30Sativa/fleet-management-system/robot/ros2_ws/src/robot_control/README.md

# robot_control

Mode manager, launch files, and a small frontier explorer for the AMR real
robot flow.

## Command Architecture

```text
Manual:
teleop/joystick -> /cmd_vel_manual -> mode_manager -> /cmd_vel -> stm32_bridge

Auto explore:
simple_frontier_explorer -> Nav2 -> /cmd_vel_nav -> mode_manager -> /cmd_vel
  -> stm32_bridge
```

Only `mode_manager_node` should publish the final `/cmd_vel`. The STM32 bridge
subscribes only to `/cmd_vel`.

## Main Topics

| Topic | Type | Role |
|---|---|---|
| `/cmd_vel_manual` | `geometry_msgs/msg/Twist` | Manual keyboard/joystick input |
| `/cmd_vel_nav` | `geometry_msgs/msg/Twist` | Nav2 velocity output |
| `/cmd_vel` | `geometry_msgs/msg/Twist` | Final selected velocity for STM32 |
| `/robot_mode` | `std_msgs/msg/String` | Command mode: `manual` or `explore` |
| `/robot_mode_state` | `std_msgs/msg/String` | Current mode state |
| `/emergency_stop` | `std_srvs/srv/SetBool` | `true` engages, `false` releases |
| `/emergency_stop_state` | `std_msgs/msg/Bool` | Emergency stop state |
| `/scan` | `sensor_msgs/msg/LaserScan` | RPLiDAR scan |
| `/odom` | `nav_msgs/msg/Odometry` | STM32 step-count odometry |
| `/ultrasonic/sonar1/range` | `sensor_msgs/msg/Range` | SR04T SONAR1 |
| `/ultrasonic/sonar2/range` | `sensor_msgs/msg/Range` | SR04T SONAR2 |
| `/ultrasonic/sonar3/range` | `sensor_msgs/msg/Range` | SR04T SONAR3 |
| `/ultrasonic/sonar4/range` | `sensor_msgs/msg/Range` | SR04T SONAR4 |
| `/map` | `nav_msgs/msg/OccupancyGrid` | SLAM map |

## TF Frames

Expected real-robot tree:

```text
map -> odom -> base_footprint -> base_link -> lidar_link
```

The launch files run `robot_state_publisher` from `robot_description`. They pass
`base_frame:=base_footprint` into `stm32_bridge` so the bridge publishes
`odom -> base_footprint` and the URDF publishes fixed robot frames below it.

The RPLiDAR launch default uses `frame_id=lidar_link` to match the current URDF.
If your hardware driver is already publishing `laser`, either set
`lidar_frame:=laser` or update the URDF/static transform consistently.

## Build

```bash
cd ~/ros2_ws
rosdep install --from-paths src --ignore-src -r -y
colcon build --packages-select robot_control stm32_bridge robot_description
source install/setup.bash
```

## Manual Mode

```bash
ros2 launch robot_control manual_mode.launch.py \
  port:=/dev/ttyACM0 \
  baudrate:=115200
```

The launch leaves keyboard teleop out so it does not share or take over the
launch terminal. In a second terminal, run:

```bash
ros2 run teleop_twist_keyboard teleop_twist_keyboard --ros-args \
  -r cmd_vel:=/cmd_vel_manual
```

For joystick control, launch your joystick stack separately and remap its output
to `/cmd_vel_manual`.
The installed drivetrain uses `invert_left:=true invert_right:=true` by default
so the `i` key (positive ROS `linear.x`) moves the robot forward. Pass both as
`false` together only if a bench test confirms the motor wiring is already
forward-oriented.

## Manual Mapping

Use this first to build a map by driving manually.

```bash
ros2 launch robot_control manual_mapping.launch.py \
  port:=/dev/ttyACM0 \
  lidar_serial_port:=/dev/ttyUSB0
```

This launches:

- `stm32_bridge`
- `mode_manager_node`
- `rplidar_ros`
- `slam_toolbox` online async
- `robot_state_publisher`

In a second terminal, run `teleop_twist_keyboard` with the `/cmd_vel_manual`
remap shown above.

Save the map after a good mapping run:

```bash
ros2 run nav2_map_server map_saver_cli -f ~/maps/amr_map
```

### Manual Mapping With Gamepad + Astra Pro

For the current laptop/VMware hardware test, use the dedicated launch below.
It starts manual STM32 control, RPLiDAR, `slam_toolbox`, a Linux gamepad, and
the Astra Pro camera. Nav2 and frontier exploration are deliberately absent.

Install the gamepad packages once on the Ubuntu VM:

```bash
sudo apt install ros-humble-joy-linux ros-humble-teleop-twist-joy
```

```bash
ros2 launch robot_control manual_mapping_gamepad_camera.launch.py \
  port:=/dev/ttyACM0 \
  lidar_serial_port:=/dev/ttyUSB0 \
  joy_dev:=/dev/input/js0 \
  camera_x:=0.25 camera_y:=0.0 camera_z:=0.35 camera_pitch:=0.17
```

Before launching, verify the Linux device names:

```bash
ls -l /dev/ttyACM* /dev/ttyUSB* /dev/input/js*
```

During mapping, verify the data path in a second terminal:

```bash
ros2 topic echo /scan --once
ros2 topic echo /odom --once
ros2 topic echo /map --once
ros2 topic echo /joy --once
ros2 topic hz /camera/depth/image_raw
ros2 topic hz /camera/depth/points
```

Save the map after driving all required areas:

```bash
mkdir -p ~/maps
ros2 run nav2_map_server map_saver_cli -f ~/maps/amr_map
```

The gamepad mapping uses button `0` as a dead-man enable button, left stick
vertical for forward/backward, and left stick horizontal for rotation. Verify
the actual device first with `ls -l /dev/input/js*` and `ros2 topic echo
/joy --once`; VMware must pass the controller through to the Ubuntu guest.

The four SR04T sensors are carried in the STM32 feedback and exposed by the
bridge as `/ultrasonic/sonar1/range` through `/ultrasonic/sonar4/range`
(`sensor_msgs/msg/Range`). Check them while mapping:

```bash
ros2 topic echo /ultrasonic/sonar1/range
ros2 topic echo /ultrasonic/sonar2/range
ros2 topic echo /ultrasonic/sonar3/range
ros2 topic echo /ultrasonic/sonar4/range
```

The schematic mapping is `SONAR1: PB0=TRIG, PB1=ECHO`,
`SONAR2: PB11=TRIG, PB12=ECHO`, `SONAR3: PB13=TRIG, PB14=ECHO`, and
`SONAR4: PB15=TRIG, PA6=ECHO` (SONAR4's ECHO is the only one on GPIOA);
connector pin 2 is TRIG and pin 3 is ECHO (SONAR4's TRIG is on connector
pin 1). The temporary URDF places all four sensors at the four corners of
the chassis (SONAR1 front-left, SONAR2 front-right, SONAR3 rear-left,
SONAR4 rear-right), each facing diagonally outward. LiDAR is at the centre
of the roof, matching the current physical mount.
Confirm the SR04T Echo electrical level before powering it: the schematic
shows a direct connection to PB1/PB12/PB14/PA6, while some SR04T modules
output 5 V. Use a divider or level shifter if the installed module does not
guarantee a 3.3 V Echo signal. These ranges are for hardware testing only
and are not fed into `slam_toolbox` yet.

## Auto Explore

```bash
ros2 launch robot_control auto_explore.launch.py \
  port:=/dev/ttyACM0 \
  lidar_serial_port:=/dev/ttyUSB0
```

This launches SLAM, Nav2 navigation-while-mapping, and
`simple_frontier_explorer`. Nav2 is remapped so its velocity output goes to
`/cmd_vel_nav`; only `mode_manager_node` publishes final `/cmd_vel`.

Optional manual override inside auto explore:

```bash
ros2 launch robot_control auto_explore.launch.py enable_teleop:=true
```

Manual input has priority over Nav2 while it is fresh. When manual input times
out, explore mode returns control to Nav2.

## Change Mode

Switch to manual:

```bash
ros2 topic pub --once /robot_mode std_msgs/msg/String "{data: manual}"
```

Switch to explore:

```bash
ros2 topic pub --once /robot_mode std_msgs/msg/String "{data: explore}"
```

When switching from explore to manual, `mode_manager_node` publishes zero
velocity and requests cancellation of the active Nav2 `NavigateToPose` goal.

## Emergency Stop

Engage:

```bash
ros2 service call /emergency_stop std_srvs/srv/SetBool "{data: true}"
```

Release:

```bash
ros2 service call /emergency_stop std_srvs/srv/SetBool "{data: false}"
```

While emergency stop is engaged, `mode_manager_node` forces `/cmd_vel` to zero
and blocks manual/Nav2 commands. The STM32 bridge converts zero Twist to the
firmware `STOP,<seq>` command.

## Test Order

1. Manual motor test:
   `ros2 launch robot_control manual_mode.launch.py`
2. Confirm LiDAR:
   `ros2 topic echo /scan --once`
3. Manual mapping:
   `ros2 launch robot_control manual_mapping.launch.py`
4. Nav2 click-goal in RViz:
   run auto launch with `enable_explorer:=false`, then send a Nav2 goal.
5. Auto explore:
   `ros2 launch robot_control auto_explore.launch.py`

## Important Tuning TODOs

- `config/nav2_params.yaml`: `robot_radius=0.47` and `inflation_radius=0.60` are
  set from the real footprint (74x55 cm -> half-diagonal ~0.461 m). `max_vel_x`
  and `max_vel_theta` are still conservative bench defaults; tune on the robot.
- `wheel_base=0.4325` m (center-to-center, matched to robot_description).
  Re-measure if the axle spacing changes; it directly affects turn rate and
  odometry heading.
- `stm32_bridge` real wheel odometry uses `wheel_radius=0.09725`, matched to the
  URDF/controller geometry.
- STM32 feedback counts are generated STEP pulses, not physical encoder ticks.
  Odometry will drift if wheels slip or motors stall.

## Troubleshooting

Robot does not move:

- Check `/emergency_stop_state` is `false`.
- Check exactly one final publisher on `/cmd_vel`: `mode_manager_node`.
- Check `stm32_bridge` opened the serial port and is receiving `/cmd_vel`.
- Check firmware receives `CMD` or `STOP` with `tools/motor_serial_debug.ps1`.

Map is distorted:

- Verify `/odom` changes in the correct direction.
- Tune `wheel_radius`, `wheel_base`, `odom_invert_left`, and
  `odom_invert_right`.
- Confirm `/scan` frame matches a valid TF under `base_footprint`.

Nav2 does not accept goals:

- Confirm TF exists: `map -> odom -> base_footprint -> base_link -> lidar_link`.
- Confirm `/map`, `/odom`, and `/scan` are publishing.
- Run with `enable_explorer:=false` and test an RViz click goal first.

TF missing:

- Check `robot_state_publisher` is running.
- Check `stm32_bridge` was launched with `base_frame:=base_footprint`.
- Check RPLiDAR `frame_id` matches `lidar_link` or your chosen frame.

Multiple `/cmd_vel` publishers:

- Teleop must publish `/cmd_vel_manual`.
- Nav2 must publish `/cmd_vel_nav`.
- Only `mode_manager_node` should publish `/cmd_vel`.

Serial STM32 not connected:

- In Linux/VM: `ls /dev/ttyACM* /dev/ttyUSB*`.
- Pass the actual port with `port:=...`.
- Add the user to `dialout`, log out, and log back in.
