30Sativa/fleet-management-system/robot/ros2_ws/src/robot_description/meshes/upper_corner_1_6.stl

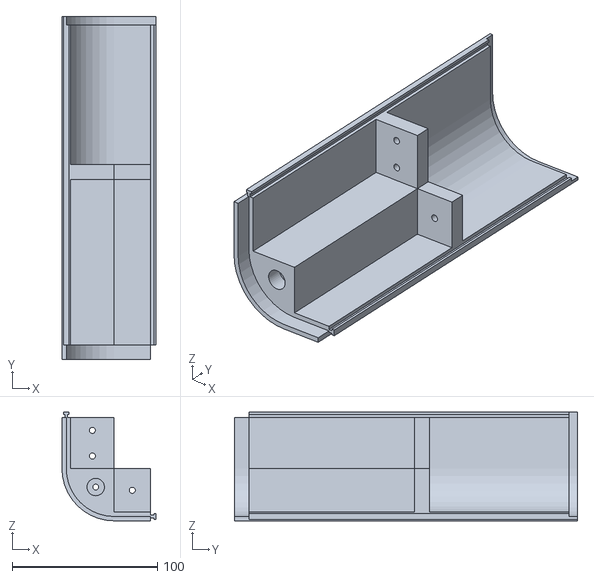
[picture p1: CAD file, 2026-09-03]
robot/ros2_ws/src/robot_description/meshes/upper_corner_1_6.stl
64.8 x 236.0 x 74.8
