30Sativa/fleet-management-system/robot/ros2_ws/src/robot_description/meshes/lower_corner_1_1.stl

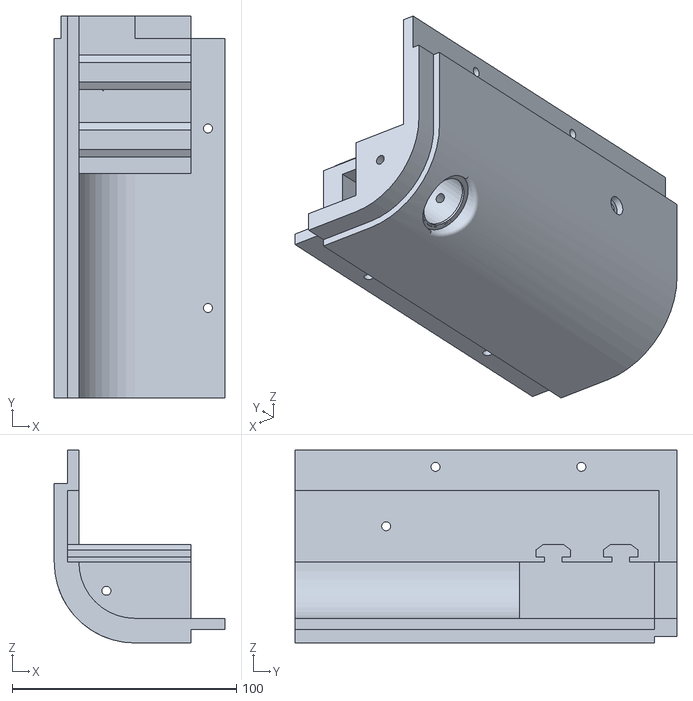
[picture p2: CAD file, 2026-09-03]
robot/ros2_ws/src/robot_description/meshes/lower_corner_1_1.stl
76.0 x 170.0 x 86.0
