30Sativa/fleet-management-system/robot/ros2_ws/src/robot_description/meshes/body_end_shell_2.stl

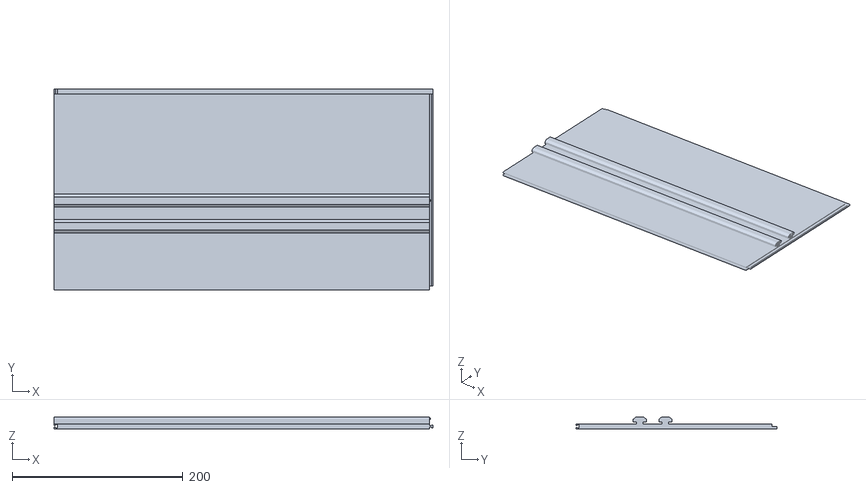
[picture p3: CAD file, 2026-09-03]
robot/ros2_ws/src/robot_description/meshes/body_end_shell_2.stl
444.0 x 236.0 x 14.0
