30Sativa/fleet-management-system/robot/ros2_ws/src/robot_description/meshes/chassis.stl

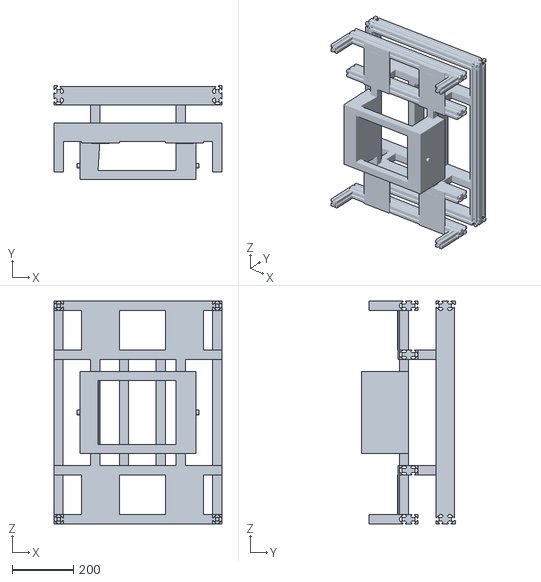
[picture p4: CAD file, 2026-09-03]
robot/ros2_ws/src/robot_description/meshes/chassis.stl
550.0 x 309.1 x 731.0
