30Sativa/fleet-management-system/robot/ros2_ws/src/robot_description/meshes/camera_mount.stl

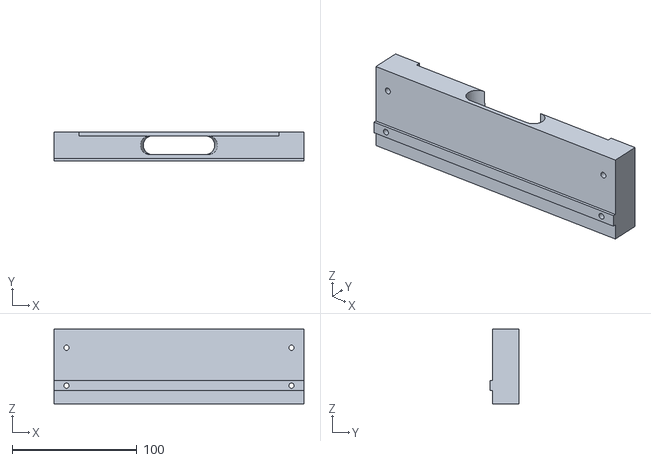
[picture p5: CAD file, 2026-09-03]
robot/ros2_ws/src/robot_description/meshes/camera_mount.stl
200.0 x 23.0 x 60.0
