30Sativa/fleet-management-system/robot/ros2_ws/src/robot_description/meshes/right_drive_wheel.stl

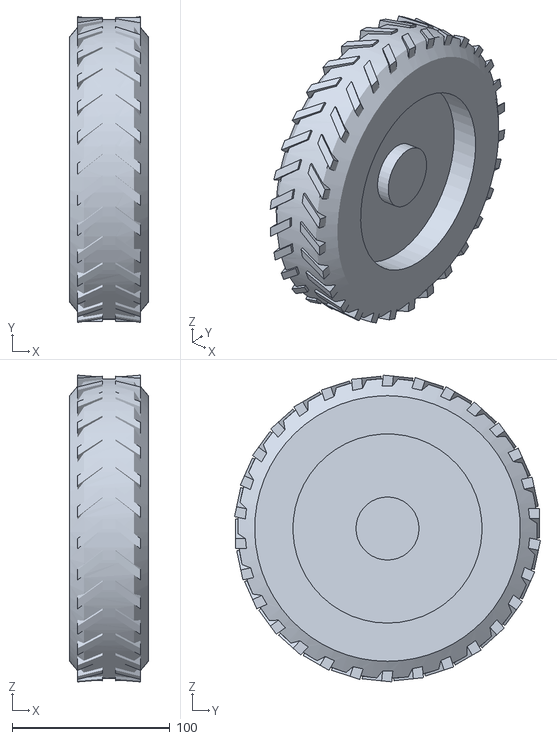
[picture p6: CAD file, 2026-09-03]
robot/ros2_ws/src/robot_description/meshes/right_drive_wheel.stl
50.0 x 194.1 x 194.6
