30Sativa/fleet-management-system/robot/ros2_ws/src/robot_description/meshes/lower_center_1.stl

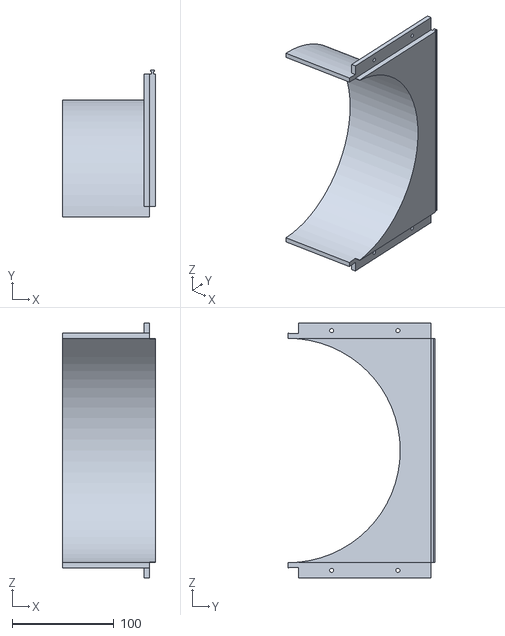
[picture p7: CAD file, 2026-09-03]
robot/ros2_ws/src/robot_description/meshes/lower_center_1.stl
91.0 x 144.1 x 250.0
