30Sativa/fleet-management-system/robot/ros2_ws/src/robot_description/meshes/body_shell_l_middle_1_1.stl

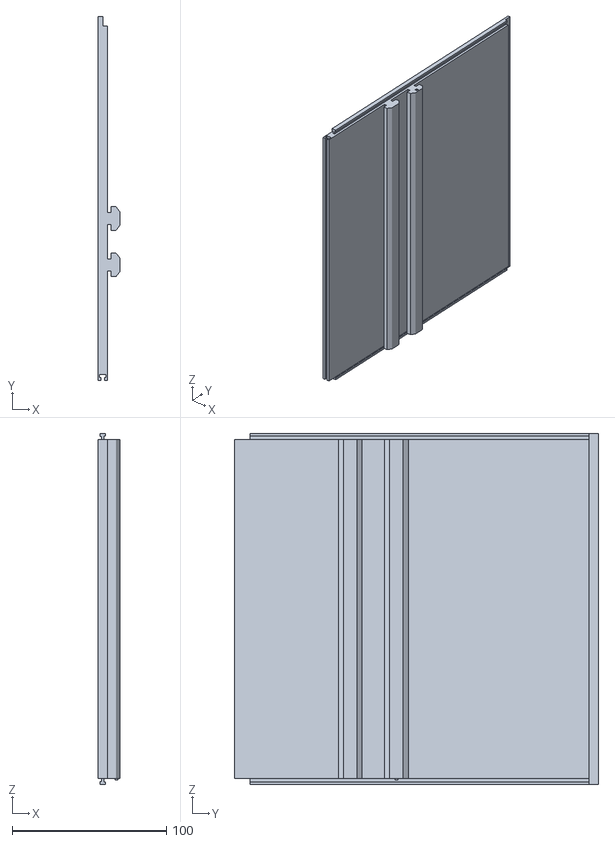
[picture p8: CAD file, 2026-09-03]
robot/ros2_ws/src/robot_description/meshes/body_shell_l_middle_1_1.stl
14.1 x 236.0 x 227.6
