30Sativa/fleet-management-system/robot/ros2_ws/src/robot_description/meshes/body_shell_1_2.stl

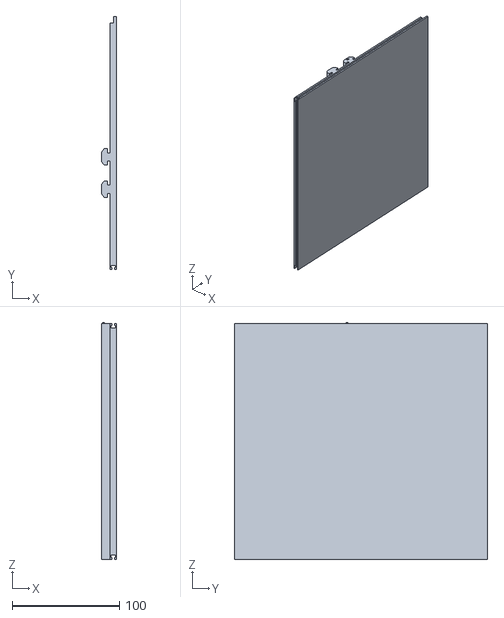
[picture p9: CAD file, 2026-09-03]
robot/ros2_ws/src/robot_description/meshes/body_shell_1_2.stl
14.0 x 236.0 x 221.0
