30Sativa/fleet-management-system/robot/ros2_ws/src/robot_description/meshes/front_left_caster.stl

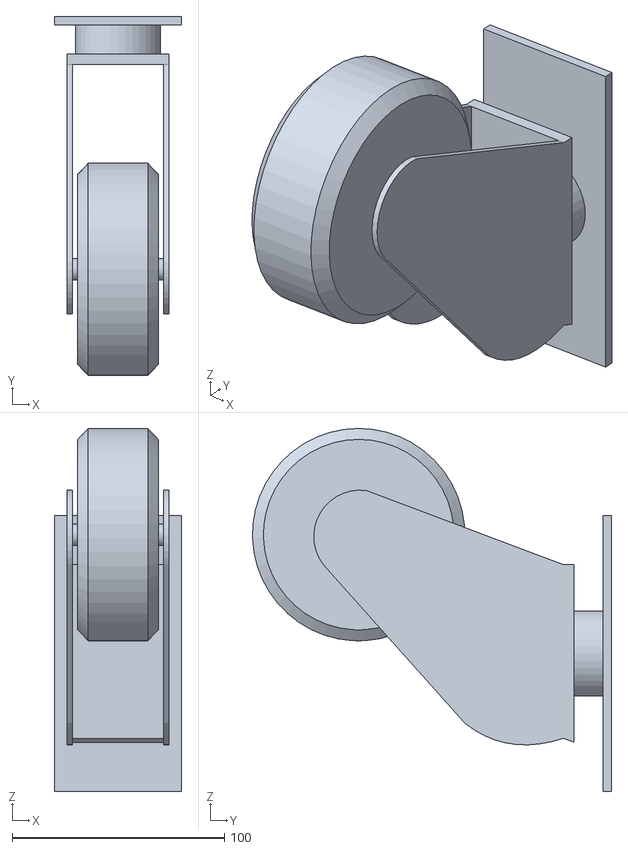
[picture p10: CAD file, 2026-09-03]
robot/ros2_ws/src/robot_description/meshes/front_left_caster.stl
60.0 x 169.0 x 171.0
