30Sativa/fleet-management-system/robot/ros2_ws/src/robot_description/meshes/lower_plate_3_1.stl

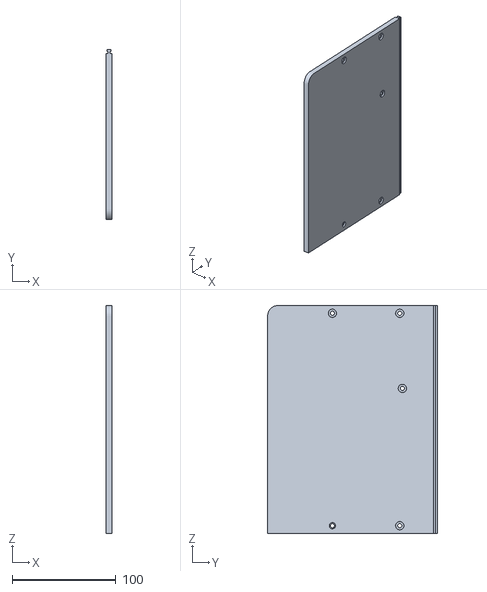
[picture p11: CAD file, 2026-09-03]
robot/ros2_ws/src/robot_description/meshes/lower_plate_3_1.stl
6.00 x 163.8 x 220.0
