30Sativa/fleet-management-system/robot/ros2_ws/src/robot_description/meshes/upper_corner_2_1.stl

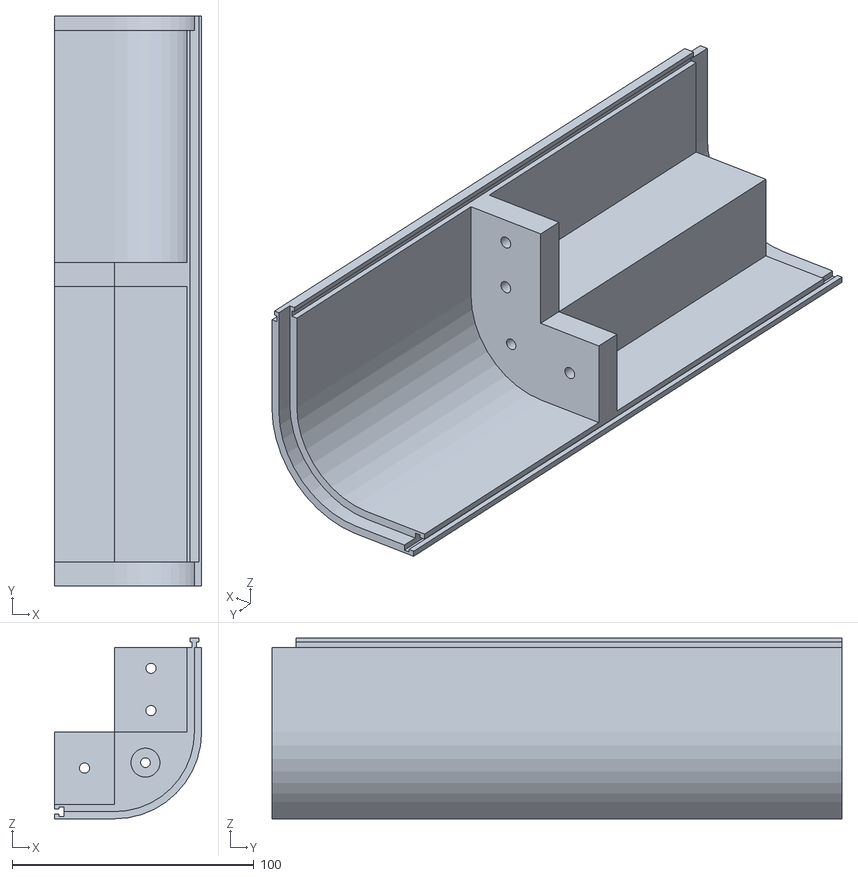
[picture p12: CAD file, 2026-09-03]
robot/ros2_ws/src/robot_description/meshes/upper_corner_2_1.stl
61.0 x 236.0 x 74.8
