30Sativa/fleet-management-system/robot/ros2_ws/src/robot_description/meshes/camera_body.stl

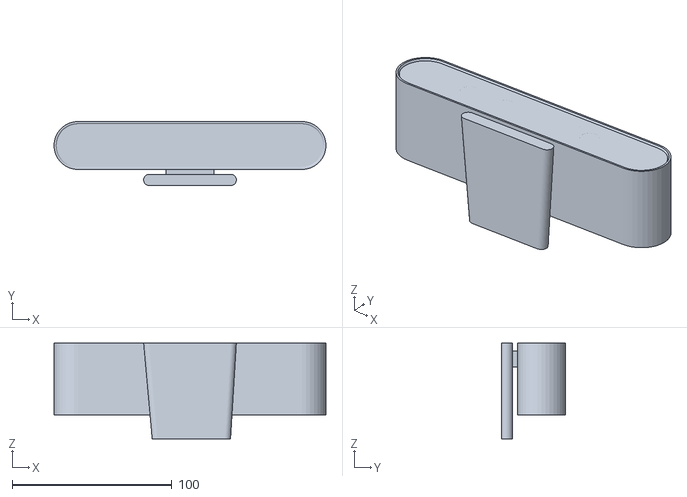
[picture p14: CAD file, 2026-09-03]
robot/ros2_ws/src/robot_description/meshes/camera_body.stl
170.0 x 40.0 x 60.0
