30Sativa/fleet-management-system/robot/ros2_ws/src/robot_description/meshes/top_cover.stl

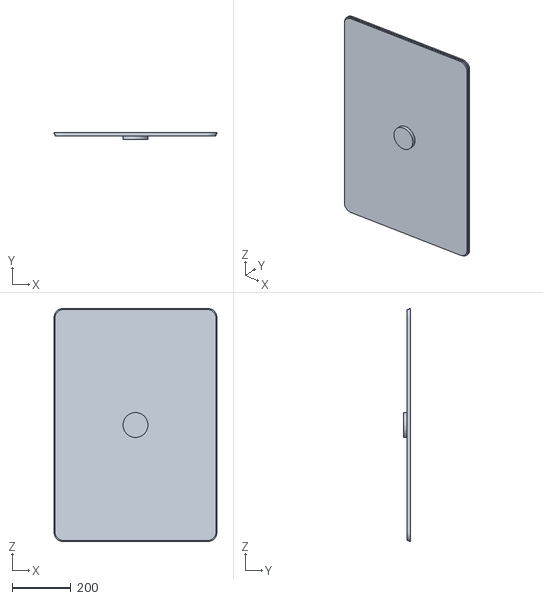
[picture p15: CAD file, 2026-09-03]
robot/ros2_ws/src/robot_description/meshes/top_cover.stl
556.0 x 25.0 x 796.0
