30Sativa/fleet-management-system/robot/ros2_ws/src/robot_description/meshes/spacer_7.stl

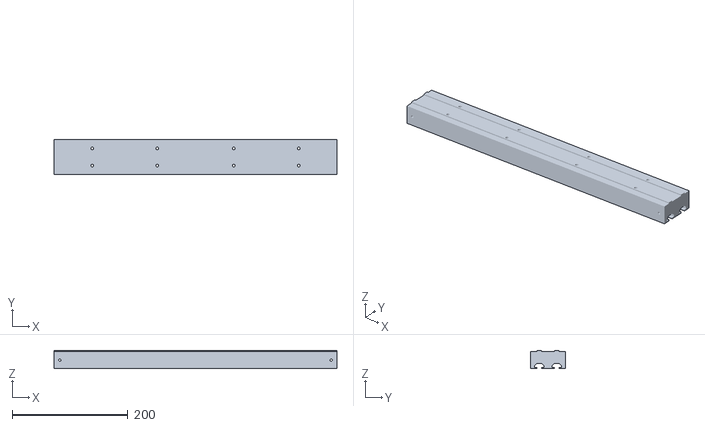
[picture p16: CAD file, 2026-09-03]
robot/ros2_ws/src/robot_description/meshes/spacer_7.stl
490.0 x 60.0 x 32.0
