30Sativa/fleet-management-system/robot/ros2_ws/src/robot_description/meshes/lidar_body.stl

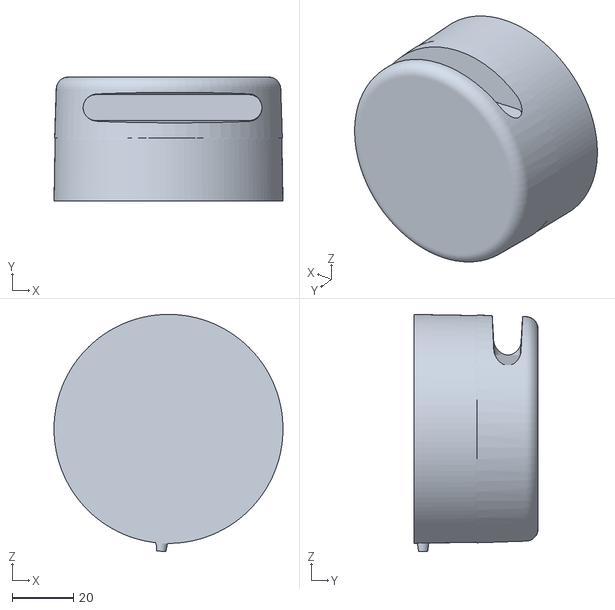
[picture p17: CAD file, 2026-09-03]
robot/ros2_ws/src/robot_description/meshes/lidar_body.stl
74.7 x 40.5 x 77.4
