30Sativa/fleet-management-system/robot/ros2_ws/src/robot_description/meshes/lower_shell_2.stl

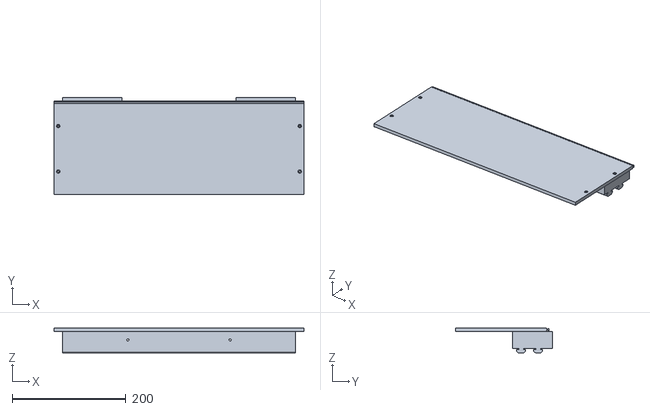
[picture p18: CAD file, 2026-09-03]
robot/ros2_ws/src/robot_description/meshes/lower_shell_2.stl
440.0 x 170.0 x 44.0
