30Sativa/fleet-management-system/(list of files, cad)

Other CAD files:
robot/ros2_ws/src/robot_description/meshes/upper_corner_1_7.stl
robot/ros2_ws/src/robot_description/meshes/lower_corner_2_2.stl
robot/ros2_ws/src/robot_description/meshes/body_shell_l_middle_1.stl
robot/ros2_ws/src/robot_description/meshes/body_shell_l_1.stl
robot/ros2_ws/src/robot_description/meshes/lower_plate_1_2.stl
robot/ros2_ws/src/robot_description/meshes/body_shell_l_2.stl
robot/ros2_ws/src/robot_description/meshes/rear_left_caster.stl
robot/ros2_ws/src/robot_description/meshes/lower_corner_1_2.stl
robot/ros2_ws/src/robot_description/meshes/lower_corner_2_1.stl
robot/ros2_ws/src/robot_description/meshes/lower_center_2.stl
robot/ros2_ws/src/robot_description/meshes/spacer_5.stl
robot/ros2_ws/src/robot_description/meshes/body_shell_1_1.stl
robot/ros2_ws/src/robot_description/meshes/front_right_caster.stl
robot/ros2_ws/src/robot_description/meshes/lower_shell_1.stl
robot/ros2_ws/src/robot_description/meshes/lower_plate_3_2.stl
robot/ros2_ws/src/robot_description/meshes/rear_right_caster.stl
robot/ros2_ws/src/robot_description/meshes/lower_plate_1_1.stl
robot/ros2_ws/src/robot_description/meshes/left_drive_wheel.stl
robot/ros2_ws/src/robot_description/meshes/upper_corner_2_2.stl
