30Sativa/fleet-management-system/robot/ros2_ws/src/robot_description/urdf/robot_expanded_hw.urdf

<?xml version="1.0" ?>
<!-- =================================================================================== -->
<!-- |    This document was autogenerated by xacro from robot/ros2_ws/src/robot_description/urdf/robot.urdf.xacro | -->
<!-- |    EDITING THIS FILE BY HAND IS NOT RECOMMENDED                                 | -->
<!-- =================================================================================== -->
<!-- =========================================================================
     robot.urdf.xacro  FILE CHINH (top-level)
     AMR differential-drive: 2 banh chinh co motor + 4 banh phu tu do.
     Cay frame chuan Nav2:
       base_footprint -> base_link -> (wheels, casters, lidar, sonar1/2, imu)
     Build: xacro robot.urdf.xacro use_sim:=true > robot.urdf
     ========================================================================= -->
<robot name="amr_robot">
  <!-- UOC LUONG: doi theo can that -->
  <material name="grey">
    <color rgba="0.4 0.4 0.4 1.0"/>
  </material>
  <material name="dark_grey">
    <color rgba="0.2 0.2 0.2 1.0"/>
  </material>
  <material name="orange">
    <color rgba="0.9 0.5 0.1 1.0"/>
  </material>
  <material name="black">
    <color rgba="0.05 0.05 0.05 1.0"/>
  </material>
  <material name="blue">
    <color rgba="0.1 0.3 0.8 1.0"/>
  </material>
  <material name="green">
    <color rgba="0.1 0.8 0.2 1.0"/>
  </material>
  <material name="yellow">
    <color rgba="0.9 0.8 0.1 1.0"/>
  </material>
  <material name="white">
    <color rgba="0.9 0.9 0.9 1.0"/>
  </material>
  <link name="lidar_link">
    <visual>
      <origin rpy="1.57079632679 0 1.57079632679" xyz="-1.637052856 -0.744854340 -1.430997681"/>
      <geometry>
        <mesh filename="package://robot_description/meshes/lidar_body.stl" scale="0.001 0.001 0.001"/>
      </geometry>
      <material name="black"/>
    </visual>
    <collision>
      <geometry>
        <cylinder length="0.0405" radius="0.038679932"/>
      </geometry>
    </collision>
    <inertial>
      <mass value="0.2"/>
      <inertia ixx="0.0001021443569762312" ixy="0.0" ixz="0.0" iyy="0.0001021443569762312" iyz="0.0" izz="0.0001496137139524624"/>
    </inertial>
  </link>
  <joint name="lidar_joint" type="fixed">
    <parent link="base_link"/>
    <child link="lidar_link"/>
    <origin rpy="0 0 0" xyz="-0.001439453 0.0 0.266499969"/>
  </joint>
  <gazebo reference="lidar_link">
    <material>Gazebo/Blue</material>
    <sensor name="lidar" type="ray">
      <pose>0 0 0 0 0 0</pose>
      <!-- false: khong ve tia laser trong gzclient (nhe hon nhieu cho VM);
           van co topic /scan, xem tia trong RViz. -->
      <visualize>false</visualize>
      <update_rate>10</update_rate>
      <ray>
        <scan>
          <horizontal>
            <samples>360</samples>
            <resolution>1.0</resolution>
            <min_angle>-3.141592</min_angle>
            <max_angle>3.141592</max_angle>
          </horizontal>
        </scan>
        <range>
          <min>0.12</min>
          <max>12.0</max>
          <resolution>0.01</resolution>
        </range>
        <noise>
          <type>gaussian</type>
          <mean>0.0</mean>
          <stddev>0.01</stddev>
        </noise>
      </ray>
      <plugin filename="libgazebo_ros_ray_sensor.so" name="lidar_controller">
        <ros>
          <remapping>~/out:=scan</remapping>
        </ros>
        <output_type>sensor_msgs/LaserScan</output_type>
        <frame_name>lidar_link</frame_name>
      </plugin>
    </sensor>
  </gazebo>
  <link name="sonar1_link">
    <visual>
      <!-- Link origin is the acoustic face; body extends into the chassis. -->
      <origin rpy="0 0 0" xyz="-0.0125 0 0"/>
      <geometry>
        <box size="0.025 0.045 0.025"/>
      </geometry>
      <material name="green"/>
    </visual>
  </link>
  <joint name="sonar1_link_joint" type="fixed">
    <parent link="base_link"/>
    <child link="sonar1_link"/>
    <origin rpy="0 0 0.78539816340" xyz="0.4013235275 0.284999692 0.0"/>
  </joint>
  <link name="sonar2_link">
    <visual>
      <!-- Link origin is the acoustic face; body extends into the chassis. -->
      <origin rpy="0 0 0" xyz="-0.0125 0 0"/>
      <geometry>
        <box size="0.025 0.045 0.025"/>
      </geometry>
      <material name="yellow"/>
    </visual>
  </link>
  <joint name="sonar2_link_joint" type="fixed">
    <parent link="base_link"/>
    <child link="sonar2_link"/>
    <origin rpy="0 0 -0.78539816340" xyz="0.4013235275 -0.281226626 0.0"/>
  </joint>
  <link name="sonar3_link">
    <visual>
      <!-- Link origin is the acoustic face; body extends into the chassis. -->
      <origin rpy="0 0 0" xyz="-0.0125 0 0"/>
      <geometry>
        <box size="0.025 0.045 0.025"/>
      </geometry>
      <material name="blue"/>
    </visual>
  </link>
  <joint name="sonar3_link_joint" type="fixed">
    <parent link="base_link"/>
    <child link="sonar3_link"/>
    <origin rpy="0 0 2.35619449019" xyz="-0.4040990795 0.284999692 0.0"/>
  </joint>
  <link name="sonar4_link">
    <visual>
      <!-- Link origin is the acoustic face; body extends into the chassis. -->
      <origin rpy="0 0 0" xyz="-0.0125 0 0"/>
      <geometry>
        <box size="0.025 0.045 0.025"/>
      </geometry>
      <material name="orange"/>
    </visual>
  </link>
  <joint name="sonar4_link_joint" type="fixed">
    <parent link="base_link"/>
    <child link="sonar4_link"/>
    <origin rpy="0 0 -2.35619449019" xyz="-0.4040990795 -0.281226626 0.0"/>
  </joint>
  <!-- ============================== IMU =============================== -->
  <link name="imu_link">
    <visual>
      <geometry>
        <box size="0.03 0.03 0.01"/>
      </geometry>
      <material name="orange"/>
    </visual>
    <inertial>
      <mass value="0.05"/>
      <inertia ixx="4.166666666666667e-06" ixy="0.0" ixz="0.0" iyy="4.166666666666667e-06" iyz="0.0" izz="7.499999999999999e-06"/>
    </inertial>
  </link>
  <joint name="imu_joint" type="fixed">
    <parent link="base_link"/>
    <child link="imu_link"/>
    <origin rpy="0 0 0" xyz="0 0 0"/>
  </joint>
  <gazebo reference="imu_link">
    <sensor name="imu_sensor" type="imu">
      <always_on>true</always_on>
      <update_rate>100</update_rate>
      <plugin filename="libgazebo_ros_imu_sensor.so" name="imu_plugin">
        <ros>
          <remapping>~/out:=imu/data</remapping>
        </ros>
        <initial_orientation_as_reference>false</initial_orientation_as_reference>
      </plugin>
    </sensor>
  </gazebo>
  <!-- ===== base_footprint (cho Nav2/odom) ===== -->
  <link name="base_footprint"/>
  <joint name="base_joint" type="fixed">
    <parent link="base_footprint"/>
    <child link="base_link"/>
    <origin rpy="0 0 0" xyz="0 0 0.2068"/>
  </joint>
  <!-- ===== base_link (than xe) ===== -->
  <link name="base_link">
    <visual>
      <origin rpy="1.57079632679 0 1.57079632679" xyz="-1.638492310 -0.744854355 -1.164497711"/>
      <geometry>
        <mesh filename="package://robot_description/meshes/chassis.stl" scale="0.001 0.001 0.001"/>
      </geometry>
      <material name="dark_grey"/>
    </visual>
    <visual>
      <origin rpy="1.57079632679 0 1.57079632679" xyz="-1.638492310 -0.744854355 -1.164497711"/>
      <geometry>
        <mesh filename="package://robot_description/meshes/lower_center_1.stl" scale="0.001 0.001 0.001"/>
      </geometry>
      <material name="grey"/>
    </visual>
    <visual>
      <origin rpy="1.57079632679 0 1.57079632679" xyz="-1.638492310 -0.744854355 -1.164497711"/>
      <geometry>
        <mesh filename="package://robot_description/meshes/lower_center_2.stl" scale="0.001 0.001 0.001"/>
      </geometry>
      <material name="grey"/>
    </visual>
    <visual>
      <origin rpy="1.57079632679 0 1.57079632679" xyz="-1.638492310 -0.744854355 -1.164497711"/>
      <geometry>
        <mesh filename="package://robot_description/meshes/upper_corner_1_6.stl" scale="0.001 0.001 0.001"/>
      </geometry>
      <material name="grey"/>
    </visual>
    <visual>
      <origin rpy="1.57079632679 0 1.57079632679" xyz="-1.638492310 -0.744854355 -1.164497711"/>
      <geometry>
        <mesh filename="package://robot_description/meshes/upper_corner_1_7.stl" scale="0.001 0.001 0.001"/>
      </geometry>
      <material name="grey"/>
    </visual>
    <visual>
      <origin rpy="1.57079632679 0 1.57079632679" xyz="-1.638492310 -0.744854355 -1.164497711"/>
      <geometry>
        <mesh filename="package://robot_description/meshes/upper_corner_2_1.stl" scale="0.001 0.001 0.001"/>
      </geometry>
      <material name="grey"/>
    </visual>
    <visual>
      <origin rpy="1.57079632679 0 1.57079632679" xyz="-1.638492310 -0.744854355 -1.164497711"/>
      <geometry>
        <mesh filename="package://robot_description/meshes/upper_corner_2_2.stl" scale="0.001 0.001 0.001"/>
      </geometry>
      <material name="grey"/>
    </visual>
    <visual>
      <origin rpy="1.57079632679 0 1.57079632679" xyz="-1.638492310 -0.744854355 -1.164497711"/>
      <geometry>
        <mesh filename="package://robot_description/meshes/lower_corner_1_1.stl" scale="0.001 0.001 0.001"/>
      </geometry>
      <material name="grey"/>
    </visual>
    <visual>
      <origin rpy="1.57079632679 0 1.57079632679" xyz="-1.638492310 -0.744854355 -1.164497711"/>
      <geometry>
        <mesh filename="package://robot_description/meshes/lower_corner_1_2.stl" scale="0.001 0.001 0.001"/>
      </geometry>
      <material name="grey"/>
    </visual>
    <visual>
      <origin rpy="1.57079632679 0 1.57079632679" xyz="-1.638492310 -0.744854355 -1.164497711"/>
      <geometry>
        <mesh filename="package://robot_description/meshes/lower_corner_2_1.stl" scale="0.001 0.001 0.001"/>
      </geometry>
      <material name="grey"/>
    </visual>
    <visual>
      <origin rpy="1.57079632679 0 1.57079632679" xyz="-1.638492310 -0.744854355 -1.164497711"/>
      <geometry>
        <mesh filename="package://robot_description/meshes/lower_corner_2_2.stl" scale="0.001 0.001 0.001"/>
      </geometry>
      <material name="grey"/>
    </visual>
    <visual>
      <origin rpy="1.57079632679 0 1.57079632679" xyz="-1.638492310 -0.744854355 -1.164497711"/>
      <geometry>
        <mesh filename="package://robot_description/meshes/top_cover.stl" scale="0.001 0.001 0.001"/>
      </geometry>
      <material name="grey"/>
    </visual>
    <visual>
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
      <origin rpy="1.57079632679 0 1.57079632679" xyz="-1.638492310 -0.744854355 -1.164497711"/>
      <geometry>
        <mesh filename="package://robot_description/meshes/spacer_5.stl" scale="0.001 0.001 0.001"/>
      </geometry>
      <material name="grey"/>
    </visual>
    <visual>
      <origin rpy="1.57079632679 0 1.57079632679" xyz="-1.638492310 -0.744854355 -1.164497711"/>
      <geometry>
        <mesh filename="package://robot_description/meshes/spacer_7.stl" scale="0.001 0.001 0.001"/>
      </geometry>
      <material name="grey"/>
    </visual>
    <!-- Camera va ga camera chi la visual. camera_link van do
         orbbec_bringup publish de tranh hai nguon TF trung nhau. -->
    <visual>
      <origin rpy="1.57079632679 0 1.57079632679" xyz="-1.638492310 -0.744854355 -1.164497711"/>
      <geometry>
        <mesh filename="package://robot_description/meshes/camera_mount.stl" scale="0.001 0.001 0.001"/>
      </geometry>
      <material name="dark_grey"/>
    </visual>
    <visual>
      <origin rpy="1.57079632679 0 1.57079632679" xyz="-1.638492310 -0.744854355 -1.164497711"/>
      <geometry>
        <mesh filename="package://robot_description/meshes/camera_body.stl" scale="0.001 0.001 0.001"/>
      </geometry>
      <material name="black"/>
    </visual>
    <!-- Collision = box don gian (khong dung mesh) de Gazebo/ODE dung va cham
         NHANH. Mesh chi tiet lam physics cham vai phut trong VM. -->
    <collision>
      <origin rpy="0 0 0" xyz="0.0 0.000049973 0.056"/>
      <geometry>
        <box size="0.802199951 0.562799988 0.421100037"/>
      </geometry>
    </collision>
    <inertial>
      <mass value="40.0"/>
      <inertia ixx="1.646896890" ixy="0.0" ixz="0.0" iyy="2.736166675" iyz="0.0" izz="3.200895293"/>
    </inertial>
  </link>
  <gazebo reference="base_link">
    <material>Gazebo/Grey</material>
  </gazebo>
  <link name="left_wheel_link">
    <visual>
      <origin rpy="1.57079632679 0 1.57079632679" xyz="-1.638492371 -0.961104370 -1.054947693"/>
      <geometry>
        <mesh filename="package://robot_description/meshes/left_drive_wheel.stl" scale="0.001 0.001 0.001"/>
      </geometry>
      <material name="black"/>
    </visual>
    <!-- Collision = cylinder (truc quay quanh Y). Nhanh hon mesh nhieu. -->
    <collision>
      <origin rpy="1.5707963 0 0" xyz="0 0 0"/>
      <geometry>
        <cylinder length="0.05" radius="0.09725"/>
      </geometry>
    </collision>
    <inertial>
      <mass value="2.0"/>
      <inertia ixx="0.005145447916666667" ixy="0.0" ixz="0.0" iyy="0.005145447916666667" iyz="0.0" izz="0.0094575625"/>
    </inertial>
  </link>
  <!-- joint quay liên tục quanh trục Y của bánh -->
  <joint name="left_wheel_joint" type="continuous">
    <parent link="base_link"/>
    <child link="left_wheel_link"/>
    <!-- Vi tri tam banh lay tu CAD -->
    <origin rpy="0 0 0" xyz="0.0 0.21625 -0.10955"/>
    <axis xyz="0 1 0"/>
    <limit effort="100.0" velocity="20.0"/>
    <dynamics damping="0.05" friction="0.1"/>
  </joint>
  <!-- thuộc tính Gazebo cho bánh: ma sát cao để không trượt -->
  <gazebo reference="left_wheel_link">
    <mu1>1.0</mu1>
    <mu2>1.0</mu2>
    <kp>1000000.0</kp>
    <kd>100.0</kd>
    <material>Gazebo/Black</material>
  </gazebo>
  <link name="right_wheel_link">
    <visual>
      <origin rpy="1.57079632679 0 1.57079632679" xyz="-1.638492371 -0.528604355 -1.054947723"/>
      <geometry>
        <mesh filename="package://robot_description/meshes/right_drive_wheel.stl" scale="0.001 0.001 0.001"/>
      </geometry>
      <material name="black"/>
    </visual>
    <!-- Collision = cylinder (truc quay quanh Y). Nhanh hon mesh nhieu. -->
    <collision>
      <origin rpy="1.5707963 0 0" xyz="0 0 0"/>
      <geometry>
        <cylinder length="0.05" radius="0.09725"/>
      </geometry>
    </collision>
    <inertial>
      <mass value="2.0"/>
      <inertia ixx="0.005145447916666667" ixy="0.0" ixz="0.0" iyy="0.005145447916666667" iyz="0.0" izz="0.0094575625"/>
    </inertial>
  </link>
  <!-- joint quay liên tục quanh trục Y của bánh -->
  <joint name="right_wheel_joint" type="continuous">
    <parent link="base_link"/>
    <child link="right_wheel_link"/>
    <!-- Vi tri tam banh lay tu CAD -->
    <origin rpy="0 0 0" xyz="0.0 -0.21625 -0.10955"/>
    <axis xyz="0 1 0"/>
    <limit effort="100.0" velocity="20.0"/>
    <dynamics damping="0.05" friction="0.1"/>
  </joint>
  <!-- thuộc tính Gazebo cho bánh: ma sát cao để không trượt -->
  <gazebo reference="right_wheel_link">
    <mu1>1.0</mu1>
    <mu2>1.0</mu2>
    <kp>1000000.0</kp>
    <kd>100.0</kd>
    <material>Gazebo/Black</material>
  </gazebo>
  <link name="front_left_caster_link">
    <visual>
      <origin rpy="1.57079632679 0 1.57079632679" xyz="-1.928486755 -0.897107056 -1.044442749"/>
      <geometry>
        <mesh filename="package://robot_description/meshes/front_left_caster.stl" scale="0.001 0.001 0.001"/>
      </geometry>
      <material name="black"/>
    </visual>
    <!-- Collision = sphere don gian thay cho mesh phu. -->
    <collision>
      <origin rpy="0 0 0" xyz="0 0 0"/>
      <geometry>
        <sphere radius="0.0855"/>
      </geometry>
    </collision>
    <inertial>
      <mass value="0.5"/>
      <inertia ixx="0.0014620500000000001" ixy="0.0" ixz="0.0" iyy="0.0014620500000000001" iyz="0.0" izz="0.0014620500000000001"/>
    </inertial>
  </link>
  <!-- fixed joint: chi mo phong hinh dang va tiep xuc, chua co swivel joint -->
  <joint name="front_left_caster_joint" type="fixed">
    <parent link="base_link"/>
    <child link="front_left_caster_link"/>
    <origin rpy="0 0 0" xyz="0.29 0.15225 -0.1213"/>
  </joint>
  <!-- Ma sat thap de banh phu khong keo le robot qua nhieu. -->
  <gazebo reference="front_left_caster_link">
    <mu1>0.0</mu1>
    <mu2>0.0</mu2>
    <kp>1000000.0</kp>
    <kd>100.0</kd>
    <material>Gazebo/Grey</material>
  </gazebo>
  <link name="front_right_caster_link">
    <visual>
      <origin rpy="1.57079632679 0 1.57079632679" xyz="-1.928504944 -0.622189758 -1.044442749"/>
      <geometry>
        <mesh filename="package://robot_description/meshes/front_right_caster.stl" scale="0.001 0.001 0.001"/>
      </geometry>
      <material name="black"/>
    </visual>
    <!-- Collision = sphere don gian thay cho mesh phu. -->
    <collision>
      <origin rpy="0 0 0" xyz="0 0 0"/>
      <geometry>
        <sphere radius="0.0855"/>
      </geometry>
    </collision>
    <inertial>
      <mass value="0.5"/>
      <inertia ixx="0.0014620500000000001" ixy="0.0" ixz="0.0" iyy="0.0014620500000000001" iyz="0.0" izz="0.0014620500000000001"/>
    </inertial>
  </link>
  <!-- fixed joint: chi mo phong hinh dang va tiep xuc, chua co swivel joint -->
  <joint name="front_right_caster_joint" type="fixed">
    <parent link="base_link"/>
    <child link="front_right_caster_link"/>
    <origin rpy="0 0 0" xyz="0.29 -0.12275 -0.1213"/>
  </joint>
  <!-- Ma sat thap de banh phu khong keo le robot qua nhieu. -->
  <gazebo reference="front_right_caster_link">
    <mu1>0.0</mu1>
    <mu2>0.0</mu2>
    <kp>1000000.0</kp>
    <kd>100.0</kd>
    <material>Gazebo/Grey</material>
  </gazebo>
  <link name="rear_left_caster_link">
    <visual>
      <origin rpy="1.57079632679 0 1.57079632679" xyz="-1.348479675 -0.897107056 -1.044442749"/>
      <geometry>
        <mesh filename="package://robot_description/meshes/rear_left_caster.stl" scale="0.001 0.001 0.001"/>
      </geometry>
      <material name="black"/>
    </visual>
    <!-- Collision = sphere don gian thay cho mesh phu. -->
    <collision>
      <origin rpy="0 0 0" xyz="0 0 0"/>
      <geometry>
        <sphere radius="0.0855"/>
      </geometry>
    </collision>
    <inertial>
      <mass value="0.5"/>
      <inertia ixx="0.0014620500000000001" ixy="0.0" ixz="0.0" iyy="0.0014620500000000001" iyz="0.0" izz="0.0014620500000000001"/>
    </inertial>
  </link>
  <!-- fixed joint: chi mo phong hinh dang va tiep xuc, chua co swivel joint -->
  <joint name="rear_left_caster_joint" type="fixed">
    <parent link="base_link"/>
    <child link="rear_left_caster_link"/>
    <origin rpy="0 0 0" xyz="-0.29 0.15225 -0.1213"/>
  </joint>
  <!-- Ma sat thap de banh phu khong keo le robot qua nhieu. -->
  <gazebo reference="rear_left_caster_link">
    <mu1>0.0</mu1>
    <mu2>0.0</mu2>
    <kp>1000000.0</kp>
    <kd>100.0</kd>
    <material>Gazebo/Grey</material>
  </gazebo>
  <link name="rear_right_caster_link">
    <visual>
      <origin rpy="1.57079632679 0 1.57079632679" xyz="-1.348479675 -0.622107056 -1.044442749"/>
      <geometry>
        <mesh filename="package://robot_description/meshes/rear_right_caster.stl" scale="0.001 0.001 0.001"/>
      </geometry>
      <material name="black"/>
    </visual>
    <!-- Collision = sphere don gian thay cho mesh phu. -->
    <collision>
      <origin rpy="0 0 0" xyz="0 0 0"/>
      <geometry>
        <sphere radius="0.0855"/>
      </geometry>
    </collision>
    <inertial>
      <mass value="0.5"/>
      <inertia ixx="0.0014620500000000001" ixy="0.0" ixz="0.0" iyy="0.0014620500000000001" iyz="0.0" izz="0.0014620500000000001"/>
    </inertial>
  </link>
  <!-- fixed joint: chi mo phong hinh dang va tiep xuc, chua co swivel joint -->
  <joint name="rear_right_caster_joint" type="fixed">
    <parent link="base_link"/>
    <child link="rear_right_caster_link"/>
    <origin rpy="0 0 0" xyz="-0.29 -0.12275 -0.1213"/>
  </joint>
  <!-- Ma sat thap de banh phu khong keo le robot qua nhieu. -->
  <gazebo reference="rear_right_caster_link">
    <mu1>0.0</mu1>
    <mu2>0.0</mu2>
    <kp>1000000.0</kp>
    <kd>100.0</kd>
    <material>Gazebo/Grey</material>
  </gazebo>
  <ros2_control name="AMRSystem" type="system">
    <hardware>
      <!-- ===== HARDWARE THAT: doi plugin nay thanh driver that cua ban ===== -->
      <plugin>diffdrive_arduino/DiffDriveArduinoHardware</plugin>
      <param name="left_wheel_name">left_wheel_joint</param>
      <param name="right_wheel_name">right_wheel_joint</param>
      <param name="device">/dev/ttyUSB0</param>
      <param name="baud_rate">57600</param>
      <param name="timeout_ms">1000</param>
      <param name="enc_counts_per_rev">3436</param>
    </hardware>
    <!-- Banh trai -->
    <joint name="left_wheel_joint">
      <command_interface name="velocity">
        <param name="min">-20.0</param>
        <param name="max">20.0</param>
      </command_interface>
      <state_interface name="velocity"/>
      <state_interface name="position"/>
    </joint>
    <!-- Banh phai -->
    <joint name="right_wheel_joint">
      <command_interface name="velocity">
        <param name="min">-20.0</param>
        <param name="max">20.0</param>
      </command_interface>
      <state_interface name="velocity"/>
      <state_interface name="position"/>
    </joint>
  </ros2_control>
</robot>
