30Sativa/fleet-management-system/robot/firmware/stm32/motor_controller/Core/Inc/main.h

#define PA0___M1_STEP_Pin GPIO_PIN_0
#define PA0___M1_STEP_GPIO_Port GPIOA
#define PA1___M1_DIR_Pin GPIO_PIN_1
#define PA1___M1_DIR_GPIO_Port GPIOA
#define PA2___M2_STEP_Pin GPIO_PIN_2
#define PA2___M2_STEP_GPIO_Port GPIOA
#define PA3___M2_DIR_Pin GPIO_PIN_3
#define PA3___M2_DIR_GPIO_Port GPIOA
#define PB0_SONAR1_TRIG_Pin GPIO_PIN_0
#define PB0_SONAR1_TRIG_GPIO_Port GPIOB
#define PB1_SONAR1_ECHO_Pin GPIO_PIN_1
#define PB1_SONAR1_ECHO_GPIO_Port GPIOB
#define PB1_SONAR1_ECHO_EXTI_IRQn EXTI1_IRQn
#define PB11_SONAR2_TRIG_Pin GPIO_PIN_11
#define PB11_SONAR2_TRIG_GPIO_Port GPIOB
#define PB12_SONAR2_ECHO_Pin GPIO_PIN_12
#define PB12_SONAR2_ECHO_GPIO_Port GPIOB
#define PB12_SONAR2_ECHO_EXTI_IRQn EXTI15_10_IRQn
#define PB13_SONAR3_TRIG_Pin GPIO_PIN_13
#define PB13_SONAR3_TRIG_GPIO_Port GPIOB
#define PB14_SONAR3_ECHO_Pin GPIO_PIN_14
#define PB14_SONAR3_ECHO_GPIO_Port GPIOB
#define PB14_SONAR3_ECHO_EXTI_IRQn EXTI15_10_IRQn
#define PB15_SONAR4_TRIG_Pin GPIO_PIN_15
#define PB15_SONAR4_TRIG_GPIO_Port GPIOB
#define PA6_SONAR4_ECHO_Pin GPIO_PIN_6
#define PA6_SONAR4_ECHO_GPIO_Port GPIOA
#define PA6_SONAR4_ECHO_EXTI_IRQn EXTI9_5_IRQn
#define PB6___IMU_SCL_BITBANG_Pin GPIO_PIN_6
#define PB6___IMU_SCL_BITBANG_GPIO_Port GPIOB
#define PB7___IMU_SDA_BITBANG_Pin GPIO_PIN_7
#define PB7___IMU_SDA_BITBANG_GPIO_Port GPIOB
