30Sativa/fleet-management-system/(commit log)

2026-06-08 Add stm32_base_controller STM32F4 project
    Import new STM32CubeIDE project for the stm32_base_controller (STM32F446RE / NUCLEO-F446RE). Adds project and IDE config files (.project, .cproject, .mxproject, .ioc), Core sources and headers (main, startup, system, ISRs, syscalls/sysmem), CMSIS and STM32F4 HAL drivers, and linker scripts (FLASH/RAM). This is the initial project and library import generated by STM32Cube for the base controller firmware.
2026-06-09 Port firmware to STM32G431 (MotorController_G431)
    Rename and migrate stm32_base_controller project into MotorController_G431 and port the codebase from STM32F4 (F446RE) to STM32G4 (G431). Updated Eclipse project files, build configurations and linker script; replaced CMSIS and STM32 HAL drivers/includes with STM32G4 variants; added new startup, system and HAL source files for the G431 MCU. Added MotorController_G431.ioc and stm32g4xx_hal_conf.h; removed many STM32F4-specific files. This change readies the firmware for building and running on the STM32G431 target.
    [MotorController_G431.ioc, main.h]
2026-06-17 Rename STM32 project and switch MCU variant
    Move/rename project directory MotorController_G431 -> motor_controller and remove obsolete IDE prefs. Update Eclipse/STM32Cube project files (.cproject, .mxproject, .project) and the .ioc to reflect the new project name and workspace paths. Change target MCU/board variant and related build settings from STM32G431CBUx to STM32G431C6Ux (linker script, startup, and toolchain IDs updated). Many HAL/CMSIS/Driver source and header files were relocated to the new path without content changes.
2026-06-19 Add USB & motor controller firmware
    Integrate USB CDC stack and motor controller firmware for the STM32 project. Changes include switching MCU target to STM32G431CBUx in project files, adding USB device/middleware (HAL PCD, USB Device Library, CDC), motor driver and motor modules, an app framework (app.h/c), usb_protocol, and numerous HAL/driver source and header files. Project metadata and IDE settings (.cproject, .mxproject, .settings) updated to include USB and middleware paths; debug/launch configs and linker script adjusted. Also add PowerShell test scripts under tools and a few small API additions to main.h (HAL_TIM_MspPostInit and pin defines).
    [MotorController_G431 Debug.cfg]
2026-06-19 Add robot_description package with URDF and launch
    Create a new robot_description ROS2 package containing a full URDF/xacro model for a differential-drive AMR and supporting files. Adds: xacro components (common properties, materials, chassis, wheels, sensors, ros2_control), expanded URDFs (hw/sim), controller config (diff_drive_controller.yaml), launch files for RViz and Gazebo, RViz config, package.xml and CMakeLists, README and RUN_SIM instructions, and a meshes placeholder. Provides ros2_control integration and notes about matching wheel_radius/wheel_separation; intended to support local simulation, odometry checks, and transition to real hardware.
    [chassis_frame.xacro, common_properties.xacro, diff_drive_controller.yaml, materials.xacro, robot.urdf.xacro, robot_expanded_hw.urdf, robot_expanded_sim.urdf, ros2_control.xacro]
2026-06-20 Update ros2_control xacro and controller config
    Add use_sim_time to diff_drive_controller.yaml and add robot_param/robot_param_node to gazebo_ros2_control plugin so the plugin obtains the URDF from robot_state_publisher (avoids parsing/override issues). Also perform minor comment cleanup (remove diacritics, rewording) and update autogenerated xacro source paths in expanded URDFs; no functional changes to joints/limits.
    [diff_drive_controller.yaml, robot_expanded_hw.urdf, robot_expanded_sim.urdf, ros2_control.xacro]
2026-06-20 Ensure Gazebo plugin path and target controller_manager
    Update gazebo.launch.py to ensure Gazebo can find gazebo_ros2_control plugins and properly spawn controllers.
    - Add get_package_prefix import and set GAZEBO_PLUGIN_PATH to include gazebo_ros2_control lib so libgazebo_ros2_control.so is found at runtime.
    - Add SetEnvironmentVariable and include the set_plugin_path action in the LaunchDescription.
    - Pass explicit --controller-manager /controller_manager arguments to joint_state_broadcaster and diff_drive_controller spawners so they register with the correct manager instance.
    - Minor comment cleanup and import adjustments.
2026-06-20 Strip URDF comments and set GAZEBO_PLUGIN_PATH
    Run xacro via subprocess, strip XML comments from the generated URDF (using a regex) and pass the cleaned URDF string as robot_description to robot_state_publisher. Add SetEnvironmentVariable to ensure GAZEBO_PLUGIN_PATH includes gazebo_ros2_control lib so Gazebo can load plugins. Also remove unused launch imports/ParameterValue/Command and tidy event handler comments. This avoids Gazebo/Humble parsing errors ('Couldn't parse param override rule') caused by XML comments and ensures controller_manager plugins load correctly.
2026-06-20 Add stm32_bridge ROS2 package
    Add a new stm32_bridge ROS2 package that bridges /cmd_vel Twist messages to an STM32 motor controller over USB CDC serial. Includes the Stm32BridgeNode implementation (stm32_bridge_node.py) which formats CMD/STOP text protocol messages, handles serial reconnects, clamping, scaling, inversion, and watchdog timeouts. Also add package metadata and entry point (package.xml, setup.py, setup.cfg, resource), a launch file with configurable parameters, and a README with protocol, usage, and tuning notes.
2026-06-20 Handle serial write timeouts and drain CDC buffer
    Improve robustness of the STM32 bridge serial comms: increase write_timeout to 1.0s, import/fallback for SerialTimeoutException, and catch SerialTimeoutException in _send_command to drop a congested frame (warn, reset_output_buffer) instead of tearing down the port. Drain incoming feedback earlier in the timer loop to avoid filling the firmware USB CDC buffer and causing spurious write timeouts; remove the duplicated _read_feedback call. Also update IDE-generated env-hash entries in the STM32 project settings.
    [stm32_bridge_node.py]
2026-06-20 Update wheel size and serial write timeout
    Adjust motor parameters and serial behavior: set WHEEL_DIAMETER_MM to 190 mm and add measured-hardware notes in motor_driver.h (57EBP98ALC motor, HBS57H 1600 pulse/rev, 10:1 gearbox => 16000 pulses/wheel rev). In stm32_bridge_node.py change serial.Serial write_timeout from 1.0 to None to disable the write timeout and avoid write() timeout errors on slow transfers.
    [stm32_bridge_node.py]
2026-06-22 Add Docker, CI, compose, and odometry bridge
    Add containerization and CI plus extend stm32_bridge with odometry/TF.
    What changed:
    - Add Dockerfile, .dockerignore, docker/ros_entrypoint.sh and docker-compose.yml to build and run the ROS2 workspace in a container.
    - Add GitHub Actions workflows: docker-build-push.yml (build/push ROS2 image) and stm32-build.yml (compile STM32 firmware and upload artifacts).
    - Expand README with architecture, workflow, Docker usage, CI notes and detailed stm32_bridge documentation.
    - Update stm32_bridge launch file to expose many new parameters for odometry, feedback handling and TF publishing.
    - Update package.xml to add nav_msgs and tf2_ros runtime deps.
    - He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
2026-06-22 Lower speed defaults; add serial open retries
    Reduce aggressive default motion settings to be bench-safe and add serial port retry logic for debugging. Changes: set max_wheel_speed_mm_s from 1000->250 and speed_scale from 1.0->0.3 in the launch file and node (also update fallback warning), update README examples and docs to explain bench-safe defaults and testing notes, and enhance tools/motor_serial_debug.ps1 with OpenRetries/OpenRetryMs parameters and a retry loop that logs warnings and fails cleanly if the port can't be opened.
    [stm32_bridge_node.py]
2026-06-23 Add odom_invert flags and odometry tests
    Introduce odom_invert_left/odom_invert_right parameters to separately invert feedback count used for odometry (distinct from the motor command invert). Propagate the new parameters through the launch file and Stm32BridgeNode (declare, read, log) and apply them when integrating feedback counts (with a comment explaining why command invert must not be reused for odometry). Update stm32_bridge README with drivetrain constants, invert/odometry guidance, assumptions and limitations. Expand top-level README with architecture, deployment and Docker instructions. Add unit tests (ros2_ws/src/stm32_bridge/test/test_odometry.py) covering odometry math, feedback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
    [stm32_bridge_node.py]
2026-06-24 Add robot_control package and launch/configs
    Introduce a new ROS2 package `robot_control` providing a mode manager and a simple frontier explorer. Adds mode_manager_node and simple_frontier_explorer executables, Nav2/SLAM/explorer YAML configs, multiple launch files for real robot and simulation (manual_mode, manual_mapping, auto_explore, sim_manual, sim_auto_explore), package metadata (package.xml, setup.py, setup.cfg), and README docs describing usage and run commands. Also adds a small `simulation` package (world and view launch) and updates top-level README with robot_control run instructions; minor edits to robot_description gazebo launch and stm32_bridge docs/launch/node/test files.
2026-06-24 Add optional SLAM and launch args to sim_manual
    Enable optional SLAM in the Gazebo manual test launch. This adds new launch arguments (use_sim_time, enable_slam, slam_params_file) and a default slam_toolbox params file, wires up an IncludeLaunchDescription for slam_toolbox (online_async_launch.py) guarded by IfCondition(enable_slam), and passes use_sim_time/slam_params_file into that launch. Also updates header docs with usage notes for driving + mapping, and cleans up/reorders some existing launch argument declarations and comments.
2026-06-24 Tweak exploration and navigation tuning
    Adjust robot exploration and Nav2 local-planner parameters to improve agility and practical behavior in cluttered environments.
    frontier_explorer.yaml:
    - Increase min_frontier_size (3->4) and min_goal_distance (0.2->0.4) and raise cluster_size_weight (0.05->0.15) to prefer larger open frontiers and avoid wasting time in tiny dead-ends.
    nav2_params.yaml (controller, costmaps, behavior, smoother):
    - Allow small reverse velocity (min_vel_x 0.0->-0.10) so the robot can back out of tight corners.
    - Increase rotational speed and responsiveness (max_vel_theta 0.50->1.20, rotational acc/limits increased) and up sample counts (vx_samples 12->16, vtheta_sample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
2026-06-25 Add arm_bridge, arm_description, Arduino stub
    Add a new arm stack: a ROS2 package (arm_bridge) providing a swappable transport layer (transport_base, serial implementation, CAN stub), the arm_bridge_node, launch files, packaging and a placeholder test; an Arduino firmware skeleton (firmware/arduino/arm_controller) with README and a starter arm_controller.ino that parses the shared command vocabulary; and an arm_description package with URDF/xacro, RViz config and a launch to visualize the SCARA arm. Purpose: decouple the arm from the car stack, keep transport (serial vs CAN) interchangeable, and provide skeletons to integrate hardware and visualization later.
    [arm.xacro, arm_standalone.urdf.xacro]
2026-06-25 Add wrist joint and curved gripper to SCARA
    Expand the SCARA arm xacro to add a continuous wrist (J_wrist) and NEMA17 motor visuals, converting the model from a 4-DOF to a 5-DOF layout. Introduces new properties (wrist_motor, wrist_len, finger_r) and a darker material, adjusts inertial/visual sizes for link2, wrist and gripper base, and repositions the gripper mount to the wrist. Replaces the previous simple finger boxes with a curved_finger macro that creates two curved gripping fingers (left/right) using composed boxes, and keeps the prismatic grip joints but updates origins/limits/axes accordingly. All changes are contained in ros2_ws/src/arm_description/urdf/arm.xacro.
    [arm.xacro]
2026-06-25 Add Gazebo simulation support for arm
    Integrate Gazebo-based simulation for the SCARA arm: add ros2_control xacro, top-level sim xacro, Gazebo world, controller config, and a launch to spawn the robot and load controllers. Update CMakeLists to install config and worlds, and package.xml to add runtime dependencies (gazebo_ros, gazebo_ros2_control, controller_manager, joint_state_broadcaster, joint_trajectory_controller). Modify arm.xacro to add collision geometry and simplify gripper fingers for reliable collision/grasping in Gazebo. README updated with usage and example commands to build, launch, and command the arm.
    [arm.xacro, arm_controllers.yaml, arm_ros2_control.xacro, arm_sim.urdf.xacro]
2026-06-25 Add pick_demo demo and controller gains
    Add a simple ROS2 demo script (scripts/pick_demo.py) that runs a fixed-sequence pick-and-place for the SCARA arm in Gazebo (no camera/AI). Update CMakeLists to install the script as an executable (ros2 run arm_description pick_demo) and extend README with usage and tuning notes. Update arm_controllers.yaml to set open_loop_control:false and add PID gains for joints (J_z, J1, J2, J_wrist, J_grip) so Gazebo position control behaves properly. POSES in the script are hard-coded numeric joint setpoints and should be tuned for your model.
    [arm_controllers.yaml]
2026-06-25 Add all-in-one Gazebo demo launch
    Add gazebo_arm_demo.launch.py to start Gazebo, spawn the SCARA robot from the arm_sim.xacro URDF, set GAZEBO_PLUGIN_PATH, start robot_state_publisher, load joint_state_broadcaster and arm_controller, and optionally run the pick_demo after controllers are ready (controlled by the auto_demo launch argument). Also update README.md with one-command usage and instructions to disable the automatic demo (auto_demo:=false). The launch uses event handlers and a TimerAction to ensure controllers are spawned before running pick_demo.
2026-06-25 Update pick demo poses and add table in world
    Adjust pick_demo.py to use a fixed, tested pose sequence for picking a can placed on a table: simplified poses, clarified joint/comment docs, and small timing cleanups. Update arm_demo.world to add a static table (0.45m high at x=0.50) and move the can model so its center sits on the table (pose z≈0.51), aligning Gazebo scene with the updated pick routine for reliable demo runs.
2026-06-25 Replace table with cylindrical pedestal
    Update arm_demo.world to replace the rectangular table model with a narrow cylindrical pedestal (model renamed from "table" to "pedestal") to provide a small-footprint support under the can. Adjustments include: pedestal geometry changed to a cylinder (radius 0.05, length 0.45) and material tint tweaked; can cylinder radius reduced from 0.033 to 0.03 in both collision and visual elements. Comments were updated to reflect the new setup and placement so the pedestal won't interfere with the robot arm.
2026-06-26 Add BNO08x IMU driver and IMU-based odom
    Add support for BNO080-series IMU: new bit-banged I2C driver (imu/bno08x.c/.h) for STM32 that handles clock-stretching, enables Rotation Vector reports and caches yaw (reported as centi-degrees). Integrate IMU into firmware: initialize and self-test on boot (configurable), enable rotation vector, and include cached yaw/yaw_valid in USB feedback (usb_protocol). Add an Arduino I2C scanner sketch for GY-BNO080X. Update ROS2 bridge node to parse the new FB format, optionally use IMU heading for odometry (parameter use_imu_heading, with automatic fallback to encoder-only if no IMU data), and add unit tests for parsing the new feedback formats. Notes: drive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
2026-08-17 Document ROS2 workspace and update robot model
    [arm.xacro, arm_controllers.yaml, arm_ros2_control.xacro, arm_sim.urdf.xacro, arm_standalone.urdf.xacro, chassis.stl, chassis_frame.xacro, common_properties.xacro]
2026-08-19 Add orbbec_bringup package; tweak Gazebo launch
    Add a new ROS2 package 'orbbec_bringup' (launch files, config, package metadata, setup, resource and README) to publish the static TF and integrate an Orbbec Astra Pro driver. Update ros2_ws/.gitignore to allow local vendor checkouts and add third_party/README.md. Modify robot_description/launch/gazebo.launch.py to add 'gui' and 'load_controllers' launch args and conditionally spawn controllers. Minor URDF cleanup (removed duplicated mesh/collision block) and update STM32 language.settings env-hash.
    [robot.urdf.xacro]
2026-08-19 Add chassis collision mesh to URDF
    Introduce a <collision> element to ros2_ws/src/robot_description/urdf/robot.urdf.xacro for the chassis using package://robot_description/meshes/chassis.stl with mesh_scale and rpy set to ${cad_to_ros_rpy}. The change includes the specified origin (xyz="-1.674842 -0.764810 -1.092814") and also closes the visual block. This provides proper collision geometry for simulation and planning.
    [robot.urdf.xacro]
2026-08-19 Improve Gazebo compatibility and physics
    This commit updates the Gazebo launch flow to set the plugin path and optionally disable ros2_control generation via a new `use_ros2_control` argument. It strips XML comments before URDF processing to avoid xacro parsing issues, keeps the robot spawn height stable, and adds a cleaner launch setup using `OpaqueFunction`.
    It also simplifies collision geometry by replacing heavy STL meshes with lightweight box, cylinder, and sphere collisions to improve Gazebo/ODE performance. The caster z-offset is adjusted so the support wheels contact the ground correctly without tipping the robot.
    [common_properties.xacro, robot.urdf.xacro, wheels.xacro]
2026-08-19 Disable lidar visualization in Gazebo
    Turn off Gazebo ray visualization for the lidar sensor to reduce visualization overhead in VM environments. The sensor still publishes /scan data, so it remains usable in RViz and downstream processing without the heavier on-screen laser rays.
    [sensors.xacro]
2026-08-19 Fix Gazebo URDF asset paths
    Resolve mesh and STL loading in Gazebo by converting `package://robot_description/` URDF references to the installed absolute package path. This ensures `gzclient` and `gzserver` can find robot geometry when launched outside the package context, preventing invisible robot models.
2026-08-21 Add Phase 1 Orbbec Astra Pro bringup and tools
    Introduce a complete Phase 1 bringup for the Orbbec Astra Pro: add docs (docs/phase1-camera.md), a dedicated Python launch (launch/astra_pro.launch.py), a wrapper launch with mount + optional RViz (launch/orbbec_with_mount.launch.py), an RViz config (rviz/astra_pro.rviz), and host scripts to setup and verify the device (scripts/setup_astra_pro.sh, scripts/verify_astra_pro.sh). Update package setup to install RViz config and scripts. Expand README with usage, troubleshooting, and Phase 1 acceptance criteria. Also apply small IDE/project metadata tweaks in firmware files and adjust MotorController debug launch entries.
2026-08-21 Add Phase 2 depth diagnostics and deployment docs
    This change adds the Phase 1 miniPC deployment checklist and the Phase 2 perception guide, documenting the Astra Pro setup, expected mount checks, and validation steps. It also introduces a Phase 2 launch file and a depth_check diagnostic node that measures depth accuracy, TF alignment, ground-plane tilt/height, and floor noise from the depth stream. Supporting package metadata, RViz config, and Astra Pro setup/verification scripts were updated to include the required dependencies and the new diagnostic entry point.
2026-08-22 Add Nav2 and Phase 4 perception stack
    This change adds the Phase 3 Nav2 setup for Astra camera obstacle integration, including local costmap configuration, launch updates, and a diagnostics node that measures the camera's actual contribution to the costmap. It also introduces the Phase 4 person-perception pipeline using OpenVINO YOLO on RGB + depth, publishes Nav2 speed limits, and adds saved map/rviz assets plus updated docs and launch defaults for headless use.
2026-08-24 Add LiDAR scan range filter and min range
    Add a laser_filters config (config/scan_range_filter.yaml) to drop LiDAR returns closer than the vehicle body (lower_threshold 0.30) and replace filtered values with inf. Update slam_toolbox_online_async.yaml to set min_laser_range: 0.2. Update manual_mapping.launch.py to remap rplidar output to /scan_raw and insert a scan_to_scan_filter_chain node that produces /scan from /scan_raw. Notes: preserves downstream topics, and requires the ros-humble-laser-filters package to be installed.
2026-08-24 Add LiDAR range filter and adjust threshold
    Lowered laser range_filter lower_threshold from 0.30 to 0.20 and expanded comments in scan_range_filter.yaml to explain tuning rationale. Updated auto_explore.launch.py and navigation.launch.py to remap rplidar output to /scan_raw and insert a laser_filters scan_to_scan_filter_chain node that republishes a cleaned /scan (removes robot-body returns). Nodes are guarded by IfCondition(enable_lidar). Notes added about dependency (ros-humble-laser-filters) and runtime tuning of the threshold.
2026-08-24 Adjust Docker runtime for manual robot testing
    This change disables automatic container restart and adds lidar configuration, host-mounted map volume, and explicit device mappings for the STM32 and RPLiDAR. The container now stays idle by default so operators can launch robot modes manually (mapping, nav, explore) via exec, while preserving flexibility for production launch configuration later.
2026-08-24 Add validation, IMU yaw timeout, and safety fixes
    Improve robustness and safety across the stack: bno08x now timestamps last yaw and reports freshness using BNO08X_YAW_TIMEOUT_MS. StopNavigator reserves goals to avoid race conditions, handles action future exceptions, and clears reservations on finish. Add python3-yaml exec_depend. ModeManager and Stm32Bridge validate finite numeric parameters and Twist messages, reject non-finite commands, and request/cancel Nav2 appropriately. Extract and improve IMU heading alignment logic in stm32_bridge. PersonPerception fixes marker pose initialization and (re)publishes clamped speed limits. Add unit tests for mode manager and odometry behaviors.
    [bno08x.c, stm32_bridge_node.py]
2026-08-25 Monorepo: move robot workspace; add AGENTS & CI
    Restructure repository to a monorepo layout and add governance/docs and CI fixes. Moves the ROS2 workspace, firmware, Dockerfile, compose and tools into robot/; updates Docker build context and STM32 CI paths. Add repo-level AGENTS.md plus backend/, robot/, and web/ AGENTS.md skeletons and detailed robot docs/ADRs (phase1..4, architecture). Add verification scripts: scripts/verify dispatcher, robot/scripts/verify (tiered checks), backend/web verify stubs. Add robot/.dockerignore and update .vscode, .gitignore. Update GitHub workflows to use robot/ context and correct STM32 artifact paths. These changes organize the project, document contracts,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
    [MotorController_G431 Debug (1).cfg, MotorController_G431 Debug.cfg, chassis.stl, common_properties.xacro, diff_drive_controller.yaml, front_left_caster.stl, front_right_caster.stl, left_drive_wheel.stl]
2026-08-25 Add CAD body meshes, xacro updates & tests
    Add 35 STL CAD meshes and integrate them into the robot xacro/URDF (28 body meshes). Update urdf common properties (body_mesh_origin, base box dims/collision), add xacro macro body_visual, and switch heavy mesh collisions to simple primitives (box/cylinder/sphere) for faster simulation. Add LiDAR mesh and two sonar links, adjust sensor origins/inertia, and tweak caster/wheel positions. Add a Python unit test (test_mesh_references.py) and enable it from CMakeLists when BUILD_TESTING is on. Update README and expanded URDFs accordingly. Co-authored-by: Copilot <223556219+Copilot@users.noreply.github.com>
    [body_end_shell_1.stl, body_end_shell_2.stl, body_shell_1_1.stl, body_shell_1_2.stl, body_shell_l_1.stl, body_shell_l_2.stl, body_shell_l_middle_1.stl, body_shell_l_middle_1_1.stl]
2026-08-26 Add support for four SR04T sonars
    Extend firmware, bridge and robot description to handle 4 SR04T ultrasonic sensors.
    - Firmware (Core/Inc, Core/Src, .ioc): add PB13/PB14/PB15/PA6 pin defs, EXTI9_5 handler, GPIO init for TRIG/ECHO, and SR04T driver updated to SR04T_SENSOR_COUNT=4 with correct TRIG/ECHO ports/pins and round-robin scheduling. USB feedback format extended to include sonar3/sonar4 values.
    - stm32_bridge: launch, node and README updated to declare/publish four sonar topics and parse the new 16-field FB format while remaining backward-compatible with the old 12-field format. Added unit test for 16-field parsing and adjusted existing test expectations.
    - robot_description: URDF/xa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
    [robot_expanded_hw.urdf, robot_expanded_sim.urdf, sensors.xacro]
2026-08-26 Enable sonar layer and reduce max range
    Add a RangeSensorLayer to the nav2 local_costmap (robot/ros2_ws/src/robot_control/config/nav2_params.yaml) and enable it with the four /ultrasonic/sonarX/range topics. Lower sonar_max_range from 6.0 to 2.0 in both the stm32_bridge launch and node (robot/ros2_ws/src/stm32_bridge/...) so the wide SR04T beam doesn't smear into false walls. Update docs (robot/docs/phase3-nav2.md) to explain rationale and usage (local-only sonar, not global).
    [stm32_bridge_node.py]
2026-08-27 Add laser_filters dependency to robot_control
    Adds <exec_depend>laser_filters</exec_depend> to robot/ros2_ws/src/robot_control/package.xml so the laser_filters package is available at runtime for nodes that require laser scan filtering.
2026-08-27 Add joystick (JOY_DEV) device mapping
    Add JOY_DEV to robot/.env.example and map the host joystick into the robot container in robot/docker-compose.yml. Defaults to /dev/input/js0; intended for using a gamepad to drive the robot manually when building maps.
2026-08-27 Add ai-assistant & digital-twin skeletons and update docs
    Add skeleton deploy units for ai-assistant and digital-twin (AGENTS.md, README.md, and scripts/verify). Update root AGENTS.md, README.md and docs/architecture.md to include the new units and clarify ownership/safety boundaries between robot perception (WP3) and the AI tour-guide (WP4). Clarify robot docs and robot_perception README/phase4 notes. Update .gitignore to ignore editor/temp and backup files. Extend scripts/verify targets to include the new folders and remove stray .fuse_hidden / backup workflow files.
2026-08-28 Set installed drivetrain command inversion
    The robot's installed drivetrain has the opposite logical direction from ROS forward motion, so both wheel command signs must be inverted by default. This updates the STM32 bridge and manual mode launch defaults, documents the bench-safe behavior, and adds a regression test ensuring a forward Twist produces negative wheel commands for the installed hardware.
    [stm32_bridge_node.py]
2026-09-01 Clarify robot-backend contract boundaries
    Document the settled architecture for the fleet bridge and dispatch flow. The backend now specifies that assignment logic belongs in Application services, while the robot-side bridge stays in robot/ and translates to ROS 2. The architecture doc was updated to mark the backend-to-robot contract boundary, deployment ownership, and the remaining protocol/auth TODOs. This keeps controllers thin and avoids hardcoding ROS concepts in backend code.
2026-09-03 Align robot CAD with real geometry and dev setup
    Update the robot URDF, wheel/mesh dimensions, and odometry defaults to match the current CAD and real hardware (0.4325 m wheelbase, 0.09725 m radius, base_footprint TF). Add the Ubuntu VMware dev Docker Compose flow and a mesh-reference regression test to guard the CAD assembly and mesh origins.
    [body_end_shell_1.stl, body_end_shell_2.stl, body_shell_1_1.stl, body_shell_1_2.stl, body_shell_l_1.stl, body_shell_l_2.stl, body_shell_l_middle_1.stl, body_shell_l_middle_1_1.stl]
2026-09-03 Align robot Docker docs and debug workflow
    This change updates the robot Docker defaults to the official 307sativa image and adds a dedicated debug compose setup for the Ubuntu VMware guest. The README now clearly distinguishes the normal production/miniPC workflow from the debug inspection workflow and the optional local-build fallback. It also documents how to pin a commit SHA in `.env`, align ROS discovery settings, and avoid running a second real-robot control stack from the VM.
2026-09-04 Refresh STM32 IDE language settings
    Update the generated STM32CubeIDE compiler settings hash for the motor controller project. This is an IDE metadata refresh and does not change the firmware logic or build configuration.
2026-09-04 Refresh STM32 IDE language settings
    Refresh the generated STM32CubeIDE language configuration after the local toolchain environment changed. This updates the compiler environment hash metadata only; no firmware logic or source code behavior was modified.
2026-09-04 Require ROS discovery server on robot LAN
    This change documents that DDS multicast is blocked on the current LAN, so the robot must use Fast DDS Discovery Server instead of default discovery. It updates the example environment and README to require a shared LAN IP for both machines, explain the miniPC service requirement, and note that containers must be restarted after .env changes.
