30Sativa/fleet-management-system/(notices)

Notices in the files:
robot/firmware/stm32/motor_controller/Core/Inc/main.h:
Copyright (c) 2026 STMicroelectronics.
All rights reserved.
This software is licensed under terms that can be found in the LICENSE file
